tsavas/mega/pantilt_orthos/pantilt_arduino mount.png

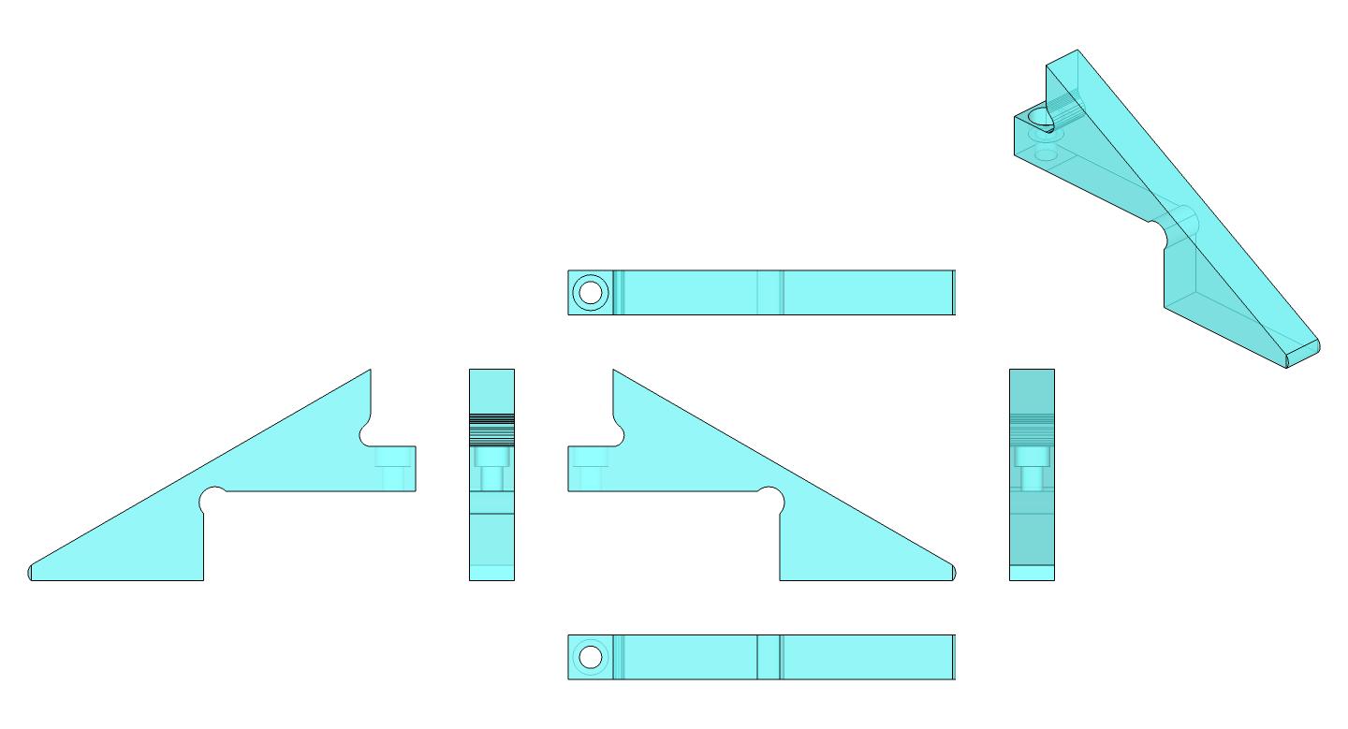
pantilt_orthos/pantilt_arduino mount.png
