tsavas/mega/pantilt_orthos/pantilt_carriage.png

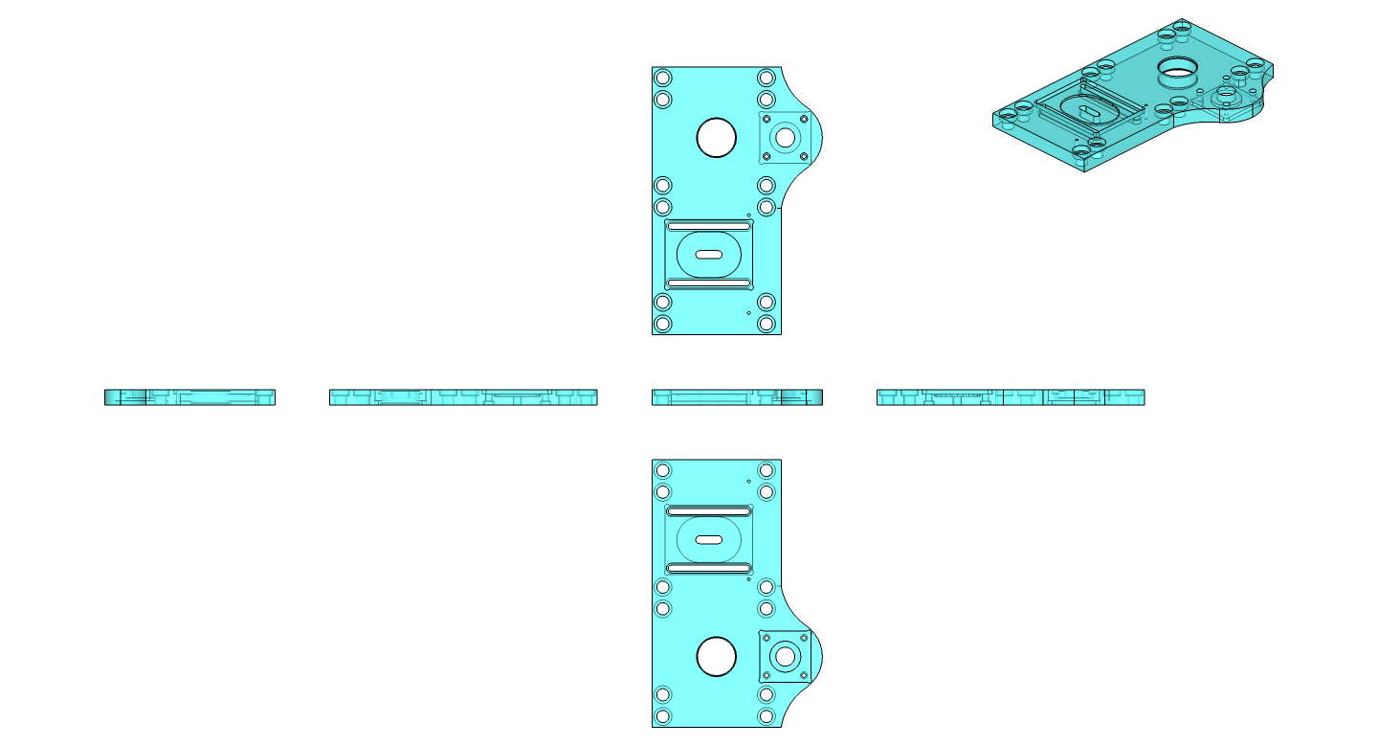
pantilt_orthos/pantilt_carriage.png
