tsavas/mega/pantilt_orthos/pantilt_side bracket_L.png

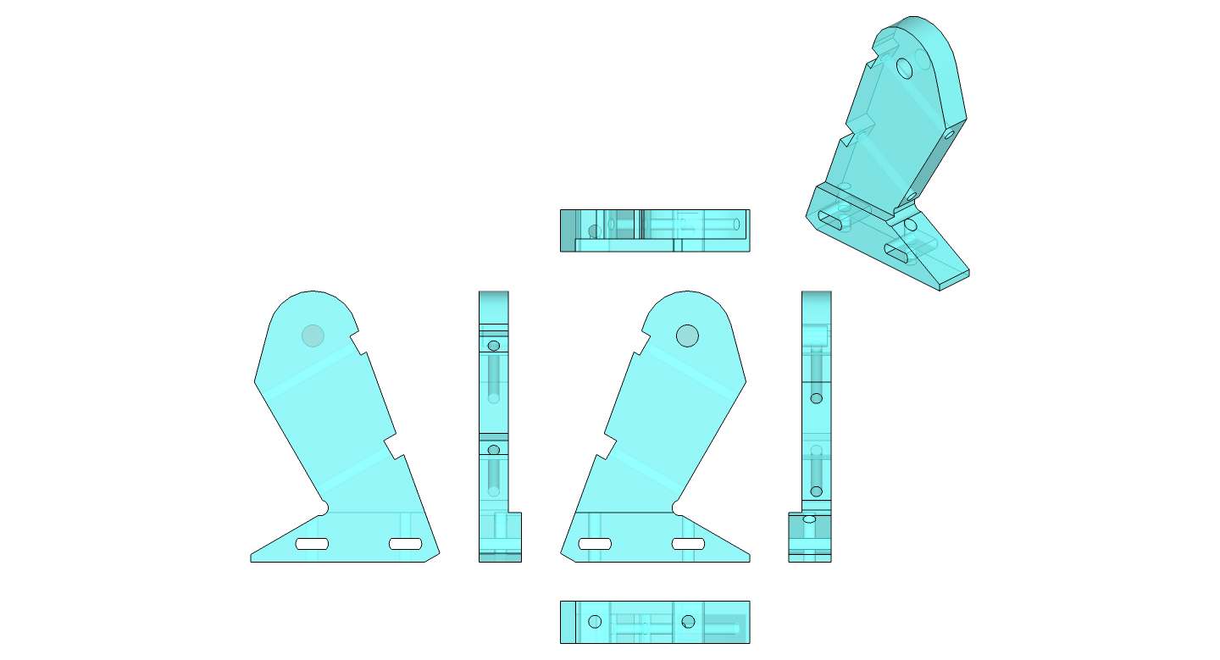
pantilt_orthos/pantilt_side bracket_L.png
