tsavas/mega/pantilt_orthos/pantilt_tilt bracket.png

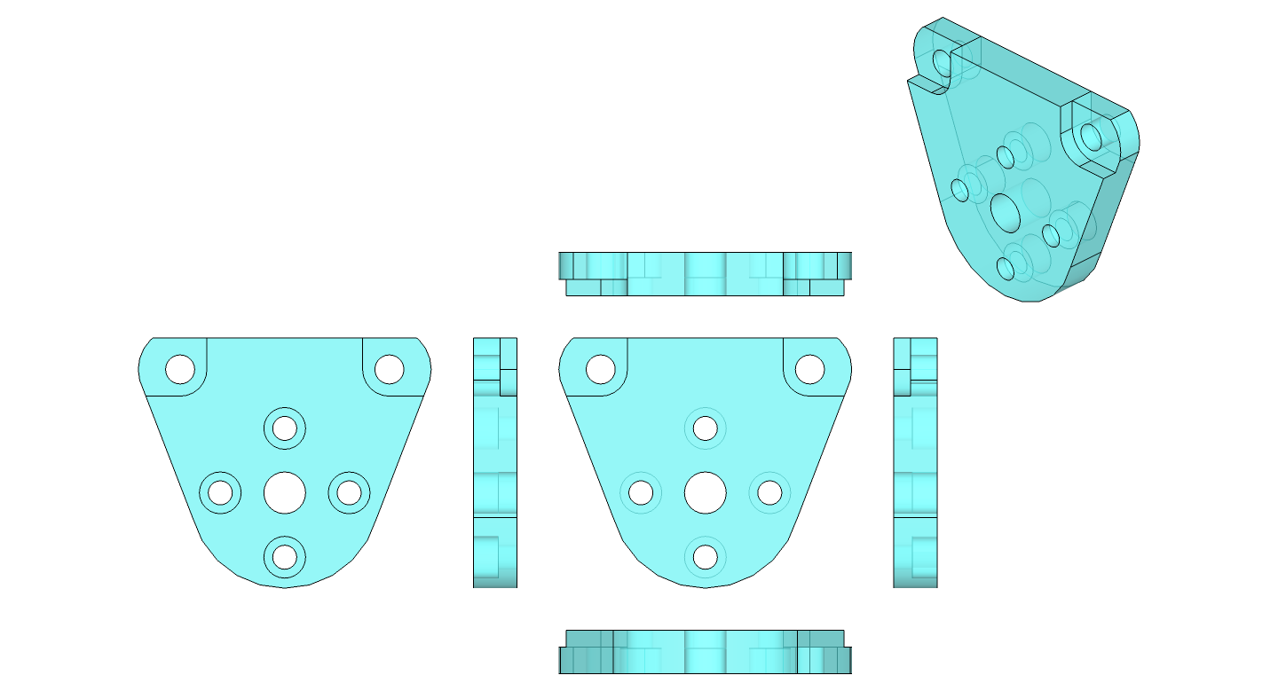
pantilt_orthos/pantilt_tilt bracket.png
