tsavas/mega/pantilt_orthos/pantilt_top plate.png

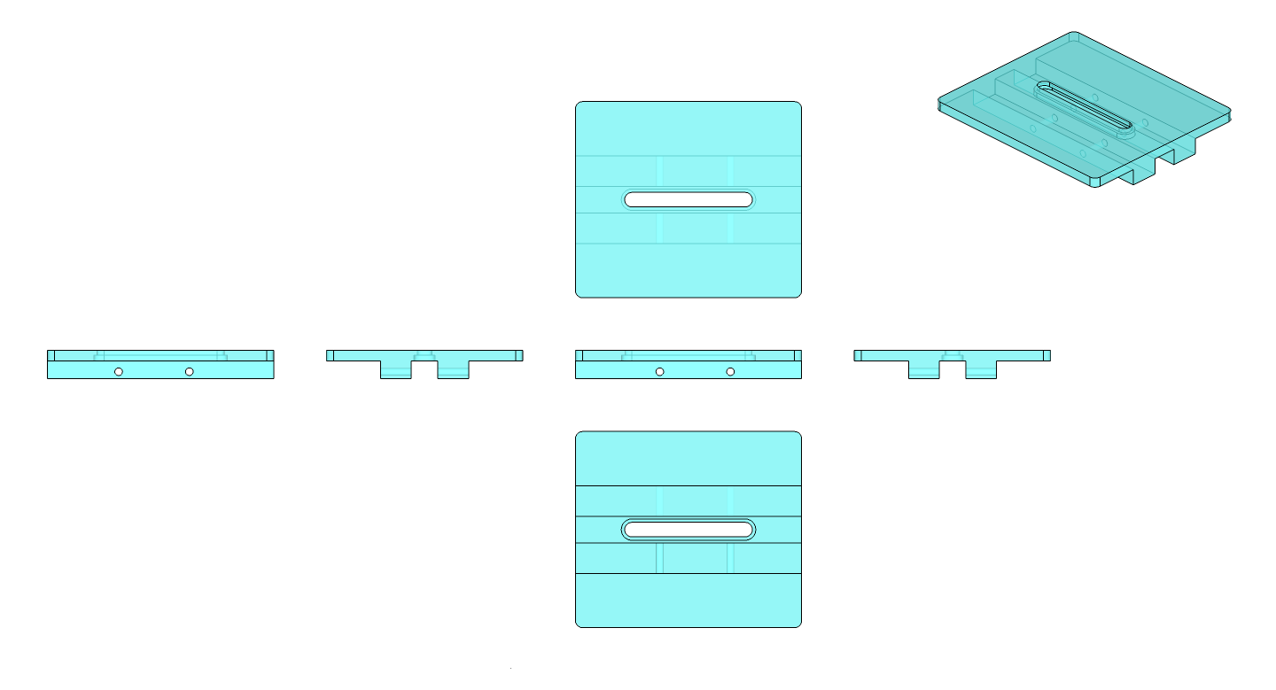
pantilt_orthos/pantilt_top plate.png
