tsavas/mega/pantilt_parts.xlsx

part | price | manufacturer | source | 2D drawing | 3D drawing | description
32 pitch, 20˚ gear rack | $33.73 | McMaster Carr | McMaster Carr (http://www.mcmaster.com/) | x | x
100T, 32 pitch 1" bore gear | $12.99 | Actarobotics | Sparkfun (https://www.sparkfun.com/products/12378) | x | x
16T, 32 pitch 6mm bore gear | $12.99 | Actarobotics | Sparkfun (https://www.sparkfun.com/products/12248) | don't need | x
16T, 32 pitch 6mm bore gear | $12.99 | Actarobotics | Sparkfun (https://www.sparkfun.com/products/12248) | don't need | x
32 pitch, 14.5˚PA worm drive | $20.66 | Boston Gear Works | Amazon (http://www.amazon.com/Boston-Gear-LTHB1-Degree-Pressure/dp/B004N6355Y?redirect=true) | x
14.5˚ PA, 50T worm gear | $38.50 | Boston Gear Works | Amazon (http://www.amazon.com/Boston-Gear-G1029-Plain-Pressure/dp/B004N84ZVK?redirect=true) | x
Igus DryLin W1040-A rail | $88.93 | Igus | Amazon (http://www.amazon.com/DryLin-W1040--Linear-Camera-Slider/dp/B0044DUCVG) | x | x
1/2" x 12" x 12" polycarbonate | $33.00 | McMaster Carr | McMaster Carr (http://www.mcmaster.com/) | o | o
1/4"x 3" pin | $4.20 | McMaster Carr | McMaster Carr (http://www.mcmaster.com/)
Nema 17 stepper motor | $13.99 | Nema | Amazon (http://www.amazon.com/Stepper-Motor-Bipolar-64oz-Printer/dp/B00PNEQI7W?redirect=true) | x
Nema 17 stepper motor | $13.99 | Nema | Amazon (http://www.amazon.com/Stepper-Motor-Bipolar-64oz-Printer/dp/B00PNEQI7W?redirect=true) | x
Nema 23 stepper motor | $16.00 | Nema | Stepper Online (http://www.omc-stepperonline.com/nema-23-stepper-motor-54v-15a-116nm1643ozin-23hs221504s-p-68.html) | x
1/4" pin clamp | $7.99 | Actarobotics | Sparkfun (https://www.sparkfun.com/products/12238) | x | x
1" clamping hub | $5.99 | Actarobotics | Sparkfun (https://www.sparkfun.com/products/12114) | x | x
1" bore shaft | $4.49 | Actarobotics | Actarobotics (https://www.servocity.com/html/1__bore_flanged_aluminum_tubin.html) | x | x
1" bore bearings | $6.48 | Actarobotics | Actarobotics (https://www.servocity.com/html/flanged_ball_bearings.html) | don't have | x
hardware
side bracket bottom hardware
stepper 1 hardware
stepper 2 hardware
stepper 3 hardware
pin bracket hardware
arduino mega
