tsavas/mega/parts 2D drawings/pin clamp.jpg

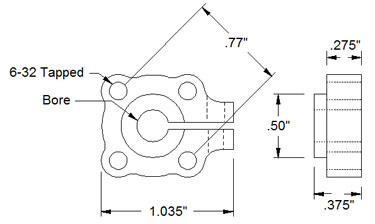
parts 2D drawings/pin clamp.jpg
