tsavas/mega/parts 2D drawings/worm drive.jpg

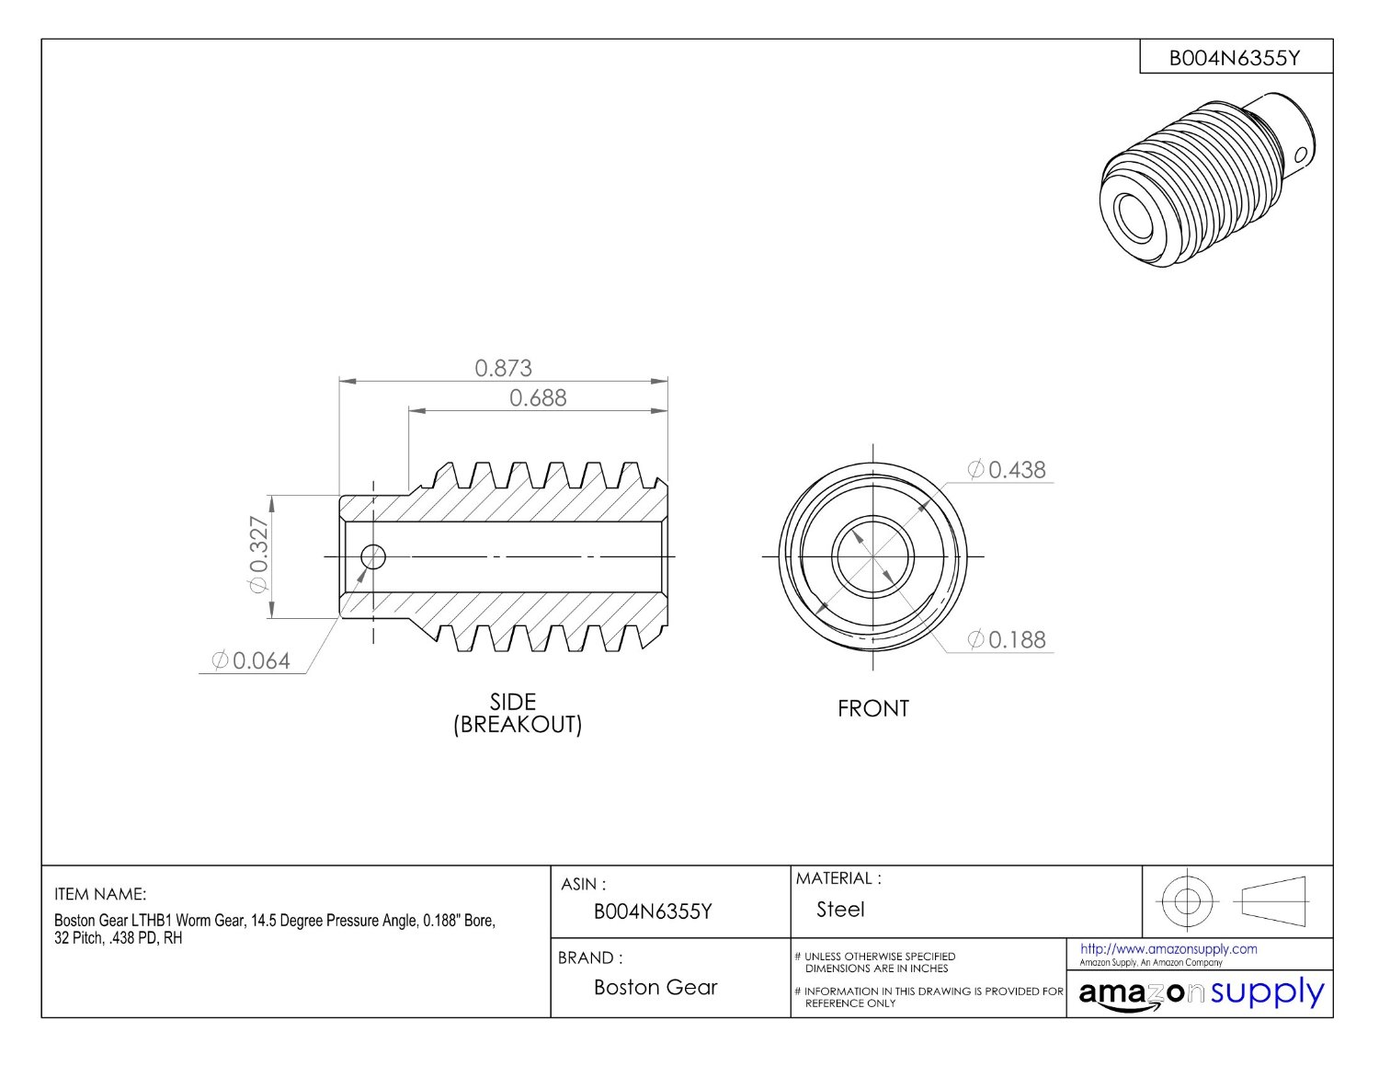
parts 2D drawings/worm drive.jpg
