tsavas/mega/parts 2D drawings/worm gear.jpg

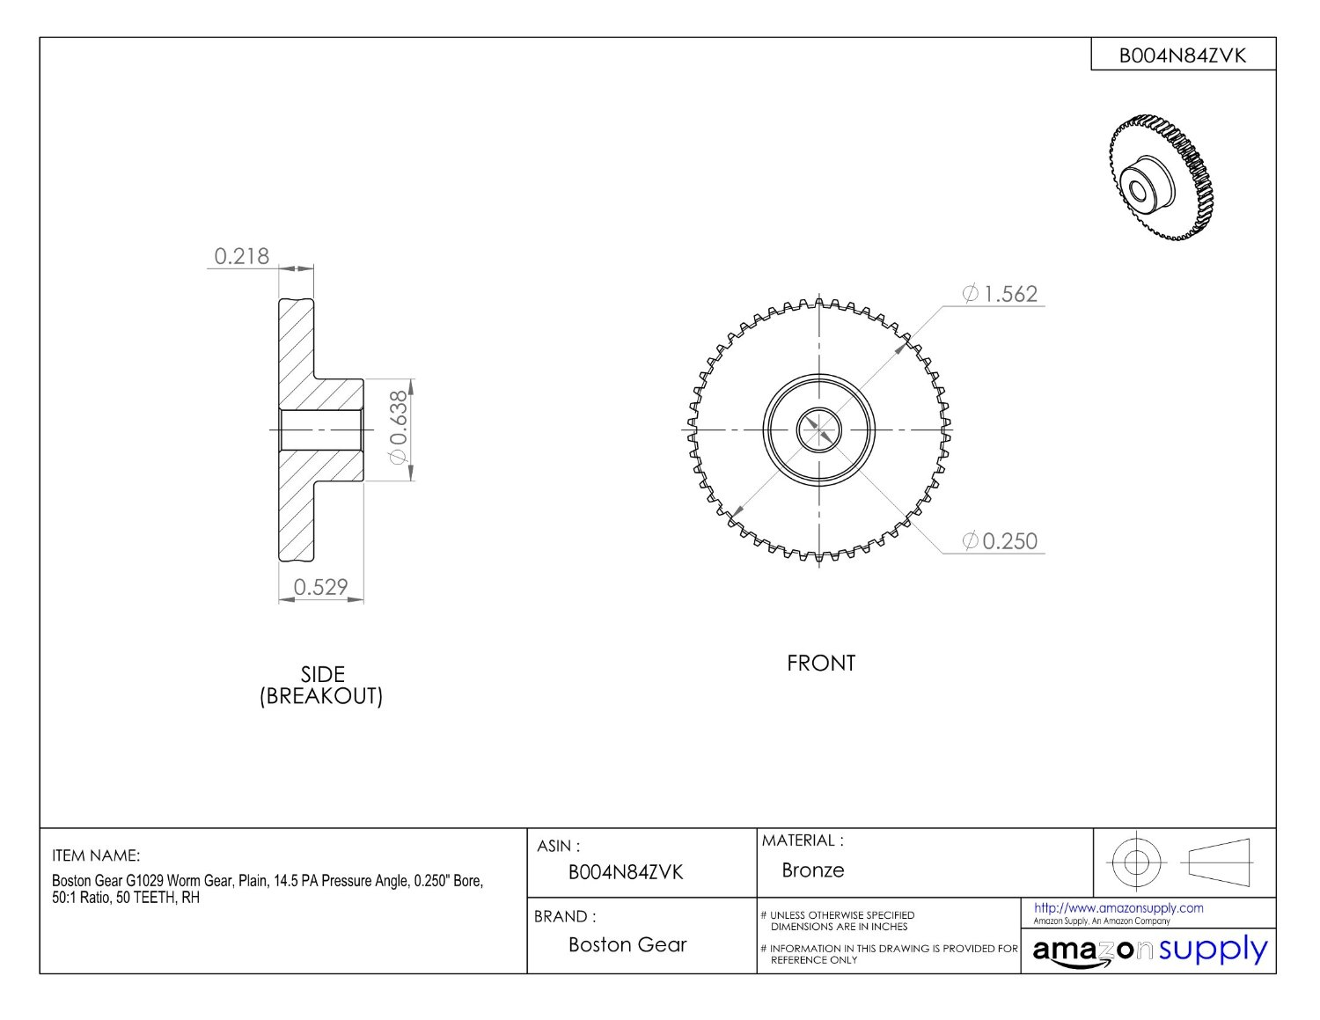
parts 2D drawings/worm gear.jpg
