tsavas/mega/pantilt_stl/pantilt_arduino mount.stl

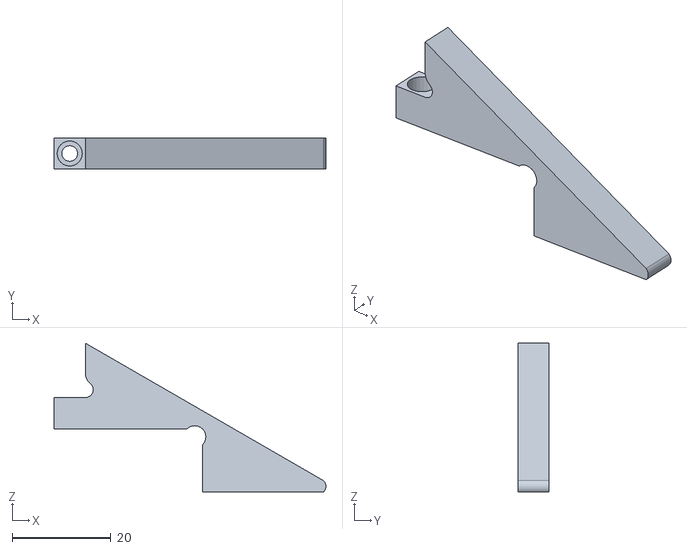
[picture p9: CAD file, 2016-05-07]
pantilt_stl/pantilt_arduino mount.stl
55.0 x 6.35 x 30.0
