tsavas/mega/parts 3D drawings/bearing.STEP

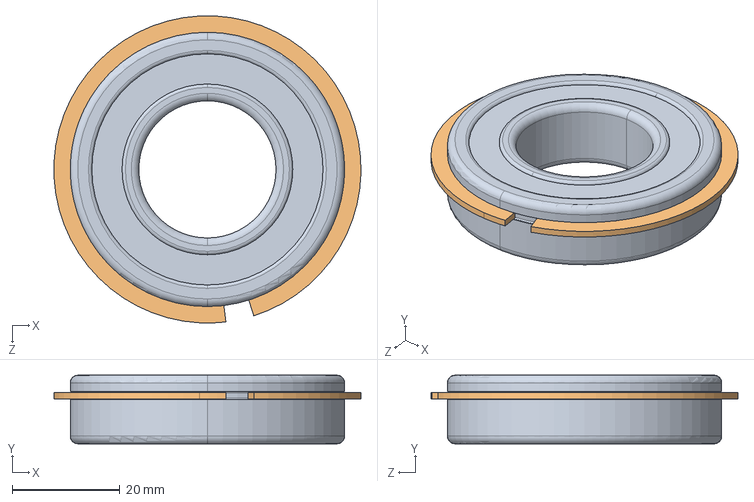
[picture p10: CAD file, 2016-05-07]
parts 3D drawings/bearing.STEP
56.8 x 12.7 x 56.9 mm
535050 snap ring
