tsavas/mega/pantilt_stl/pantilt_side bracket_R.stl

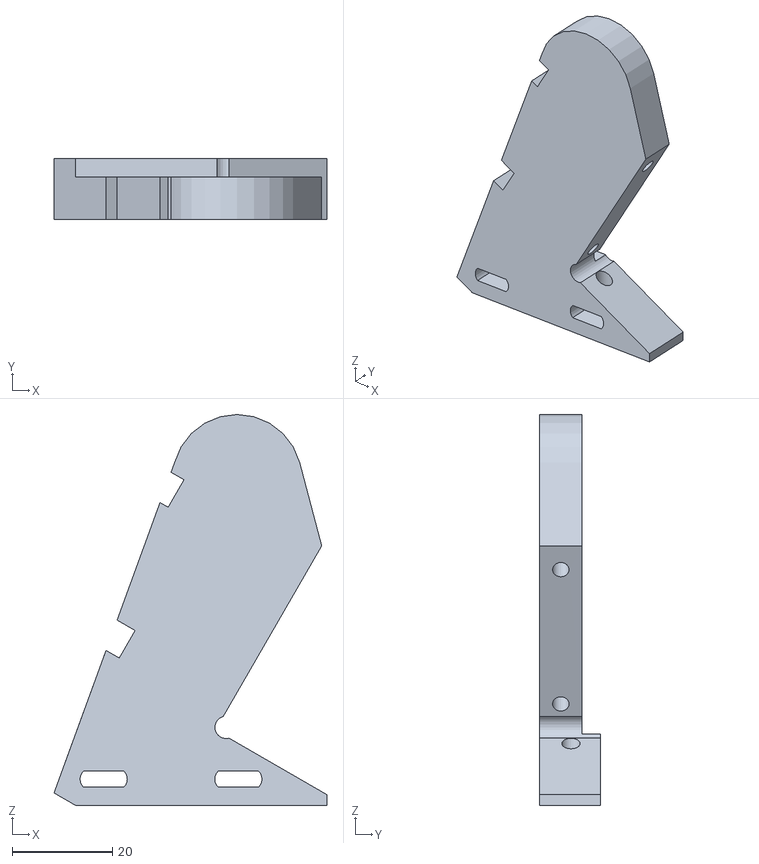
[picture p11: CAD file, 2016-05-07]
pantilt_stl/pantilt_side bracket_R.stl
54.6 x 12.2 x 78.2
