tsavas/mega/pantilt_stl/pantilt_carriage.stl

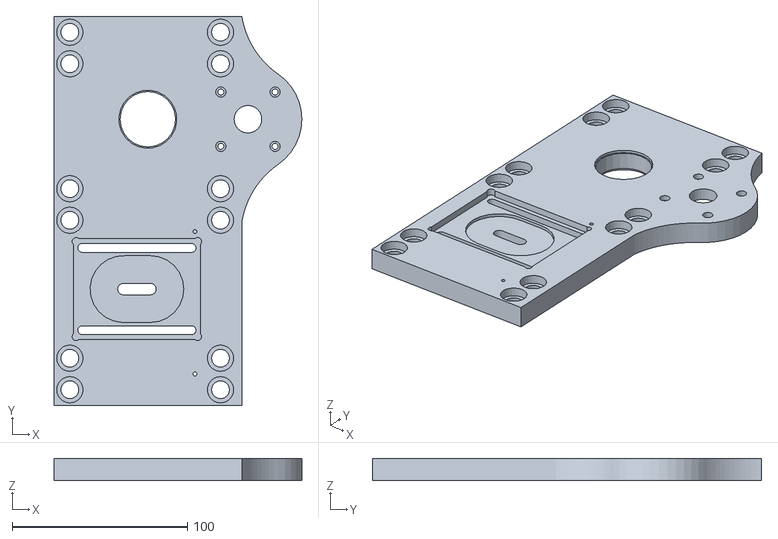
[picture p12: CAD file, 2016-05-07]
pantilt_stl/pantilt_carriage.stl
141.5 x 222.1 x 12.7
