tsavas/mega/parts 3D drawings/clamp hub.step

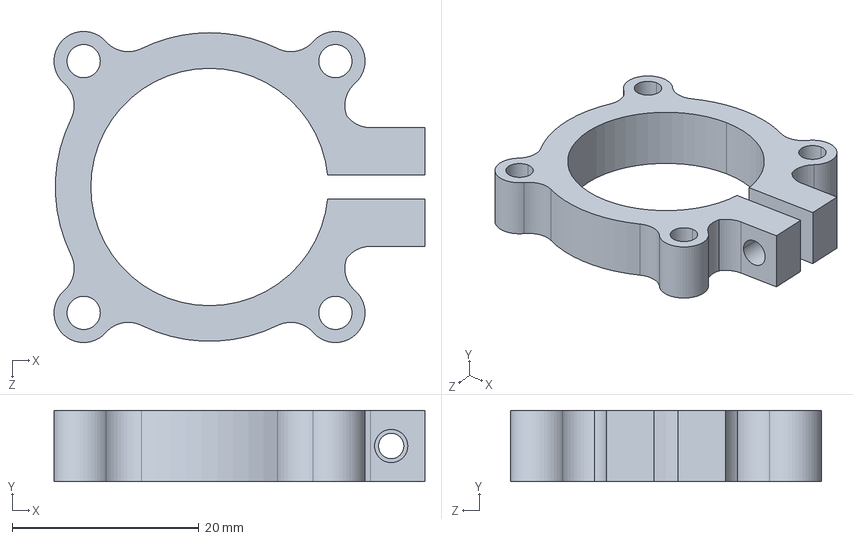
[picture p13: CAD file, 2016-05-07]
parts 3D drawings/clamp hub.step
39.7 x 7.62 x 33.3 mm
