tsavas/mega/pantilt_stl/pantilt_top plate.stl

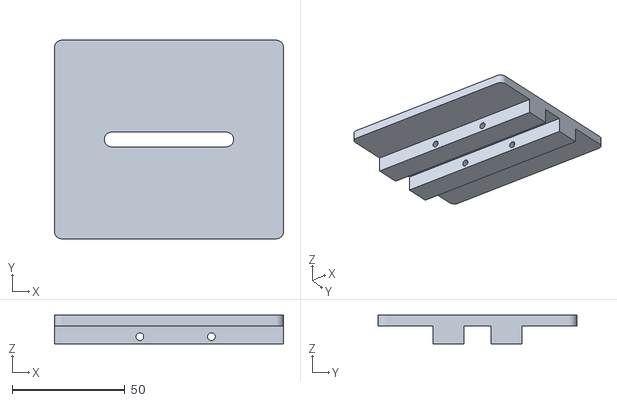
[picture p14: CAD file, 2016-05-07]
pantilt_stl/pantilt_top plate.stl
101.6 x 88.1 x 12.7
