tsavas/mega/parts 3D drawings/small gear.step

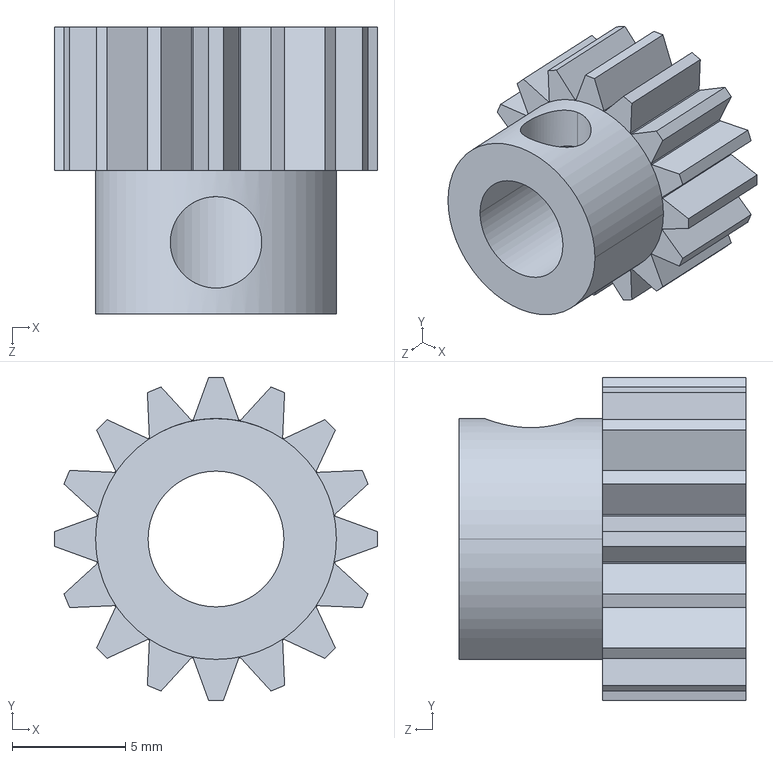
[picture p15: CAD file, 2016-05-07]
parts 3D drawings/small gear.step
14.3 x 14.3 x 12.7 mm
