tsavas/mega/pantilt_stl/pantilt_tilt bracket.stl

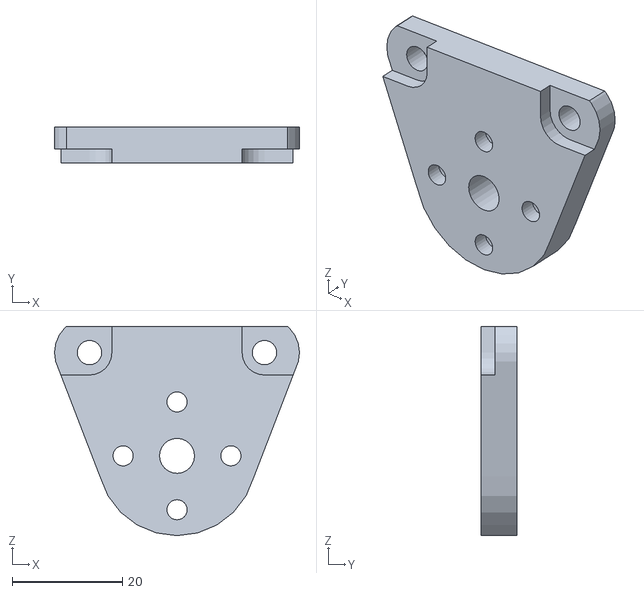
[picture p16: CAD file, 2016-05-07]
pantilt_stl/pantilt_tilt bracket.stl
44.5 x 6.60 x 38.0
