tsavas/mega/parts 3D drawings/WS_10_40_200_1.stp

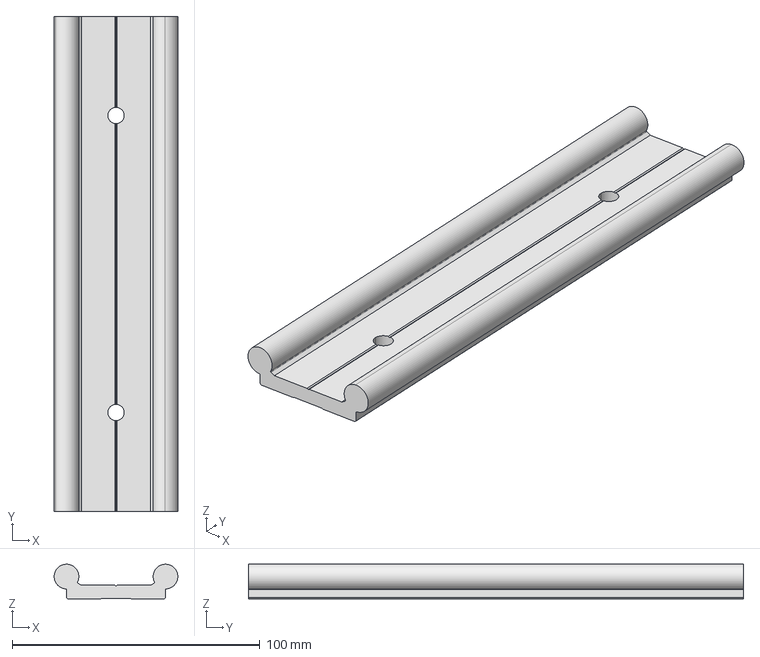
[picture p17: CAD file, 2016-05-07]
parts 3D drawings/WS_10_40_200_1.stp
50.0 x 200.0 x 14.0 mm
