tsavas/mega/parts 3D drawings/hollow shaft.STEP

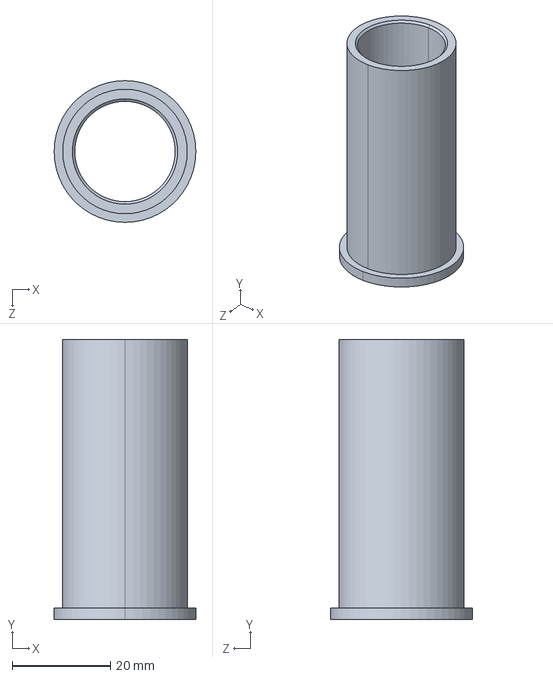
[picture p18: CAD file, 2016-05-07]
parts 3D drawings/hollow shaft.STEP
28.9 x 57.1 x 28.9 mm
