tsavas/mega/parts 3D drawings/100T Gear.stp

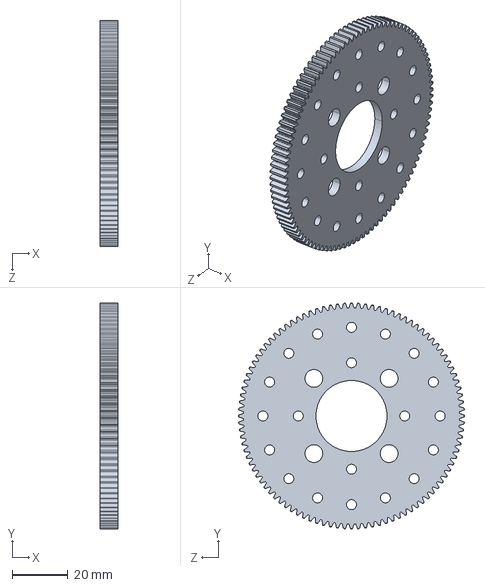
[picture p19: CAD file, 2016-05-07]
parts 3D drawings/100T Gear.stp
6.35 x 81.0 x 81.0 mm
