tsavas/mega/parts 3D drawings/7854K130.STEP

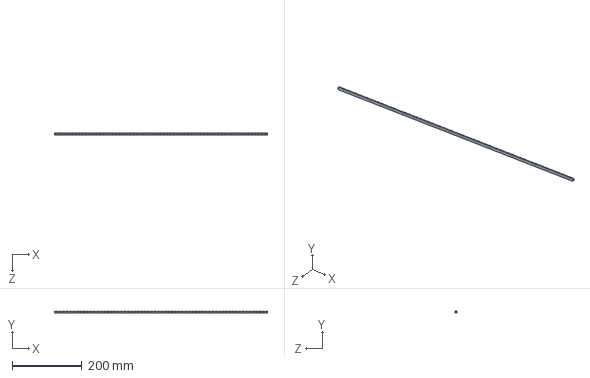
[picture p21: CAD file, 2016-05-07]
parts 3D drawings/7854K130.STEP
609.6 x 4.78 x 4.76 mm
