tsavas/mega/(list of files, cad)

Other CAD files:
pantilt_stl/pantilt_side bracket_L.stl
pantilt_dxf/pantilt_arduino mount.dxf
pantilt_dxf/pantilt_carriage.dxf
pantilt_dxf/pantilt_side bracket_L.dxf
pantilt_dxf/pantilt_side bracket_R.dxf
pantilt_dxf/pantilt_tilt bracket.dxf
pantilt_dxf/pantilt_top plate.dxf
