tsavas/mega/parts 2D drawings/DryLin WQ10.pdf

# DryLin® W Linear Guide Systems Double Rail and Bearing Block - Square

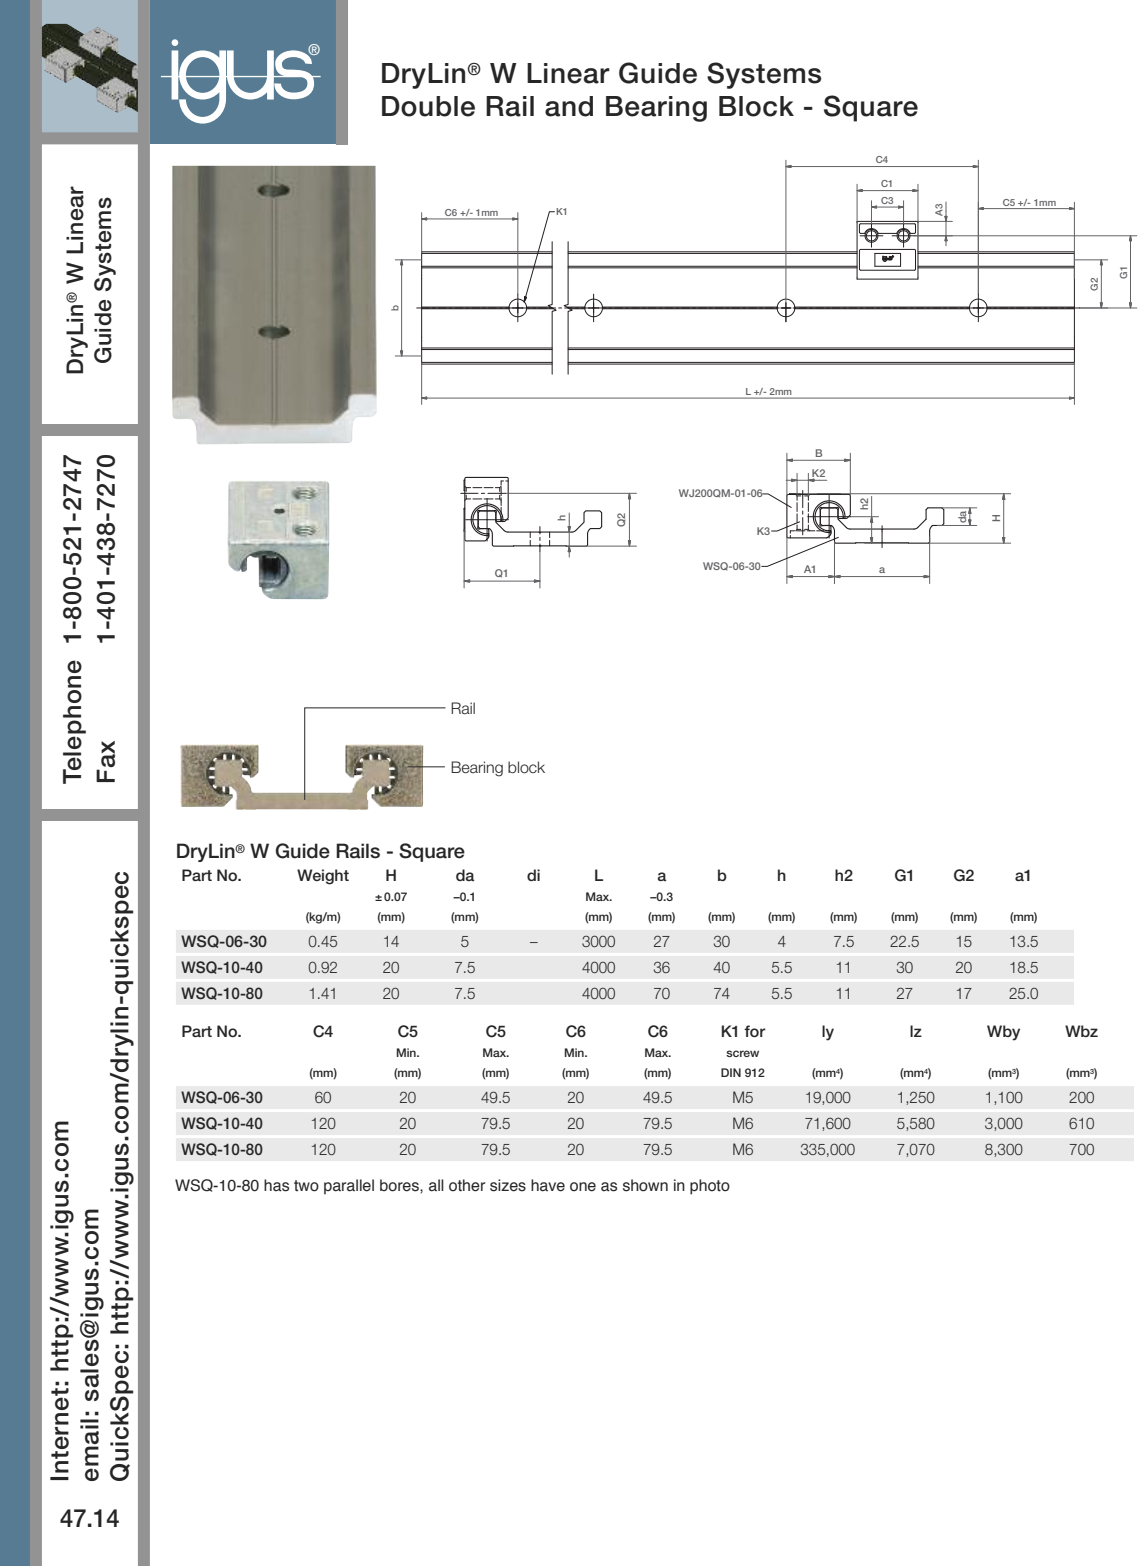
[picture p22: page 1]
Dry; Lin; uid; ste; Intern; et: http://; ail: s; ale; uic; c: http://; drylin-q; Tele; WSQ-06-30; Rail; Bearing block; Part No.; K1 for; Wby; Wbz; Min.; Max.; screw; DIN 912; (mm⁴); (mm³); WSQ-10-40; WSQ-10-80; Weight

DryLin® W Guide Rails - Square

WSQ-10-80 has two parallel bores, all other sizes have one as shown in photo

# Guide Carriage, Fitted - Square

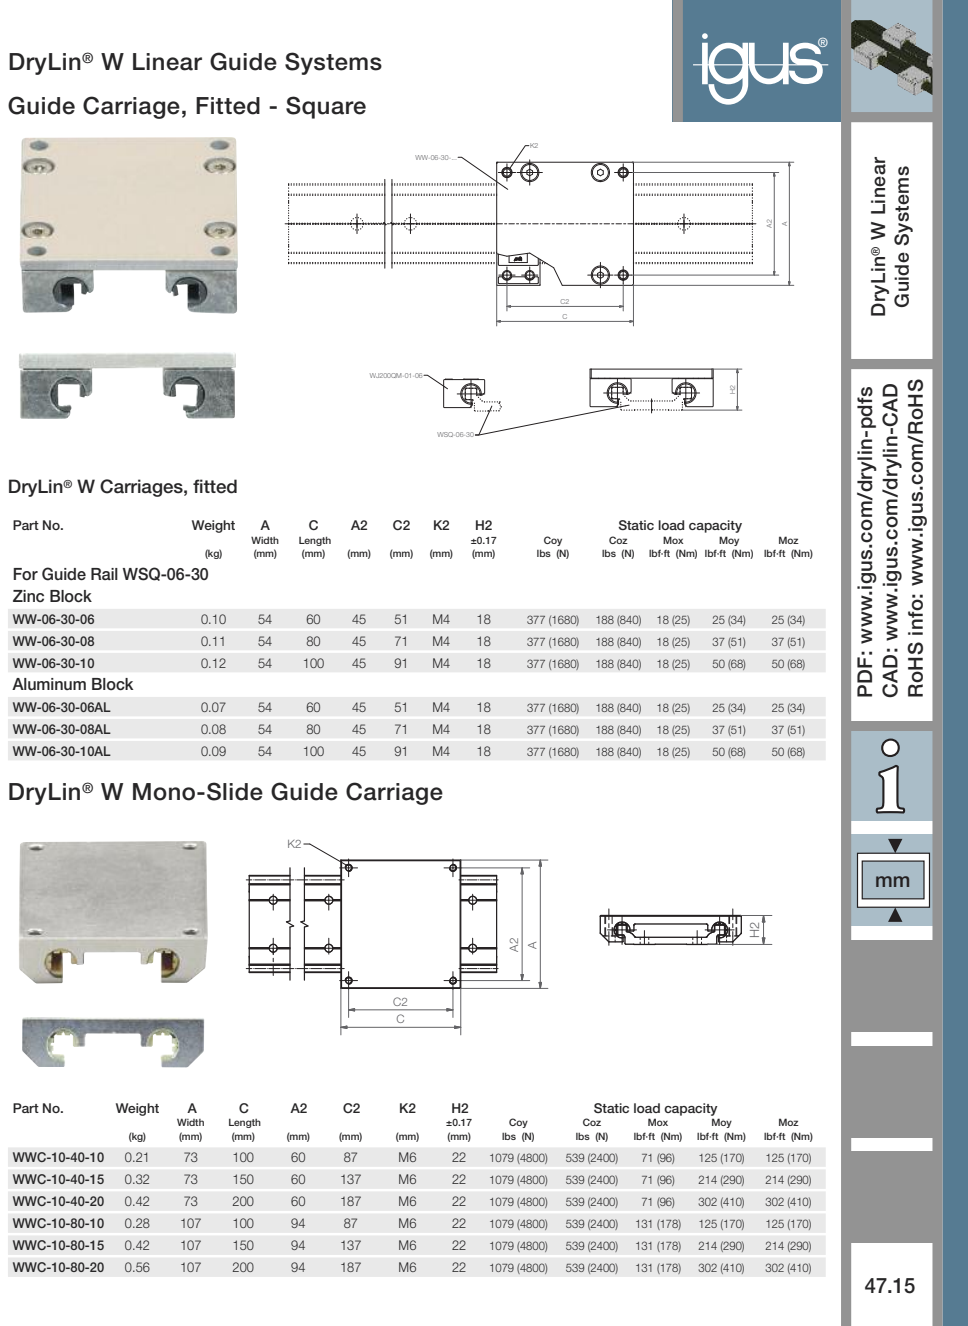
[picture p23: page 2]
drylin-p; dfs; drylin-C; S info: w; Dry; Lin; uid; ste; WSQ-06-30; Part No.; Weight; Static load capacity; Width; Length; Coy; Coz; Mox; Moy; Moz; lbs (N); lbf·ft (Nm) lbf·ft (Nm) lbf·ft (Nm); Aluminum Block; lbf·ft (Nm); WWC-10-40-10; WWC-10-40-15; WWC-10-40-20; WWC-10-80-10; WWC-10-80-15; WWC-10-80-20

DryLin® W Carriages, fitted

For Guide Rail WSQ-06-30
Zinc Block

DryLin® W Mono-Slide Guide Carriage

# Double Rail and Bearing Block - Round

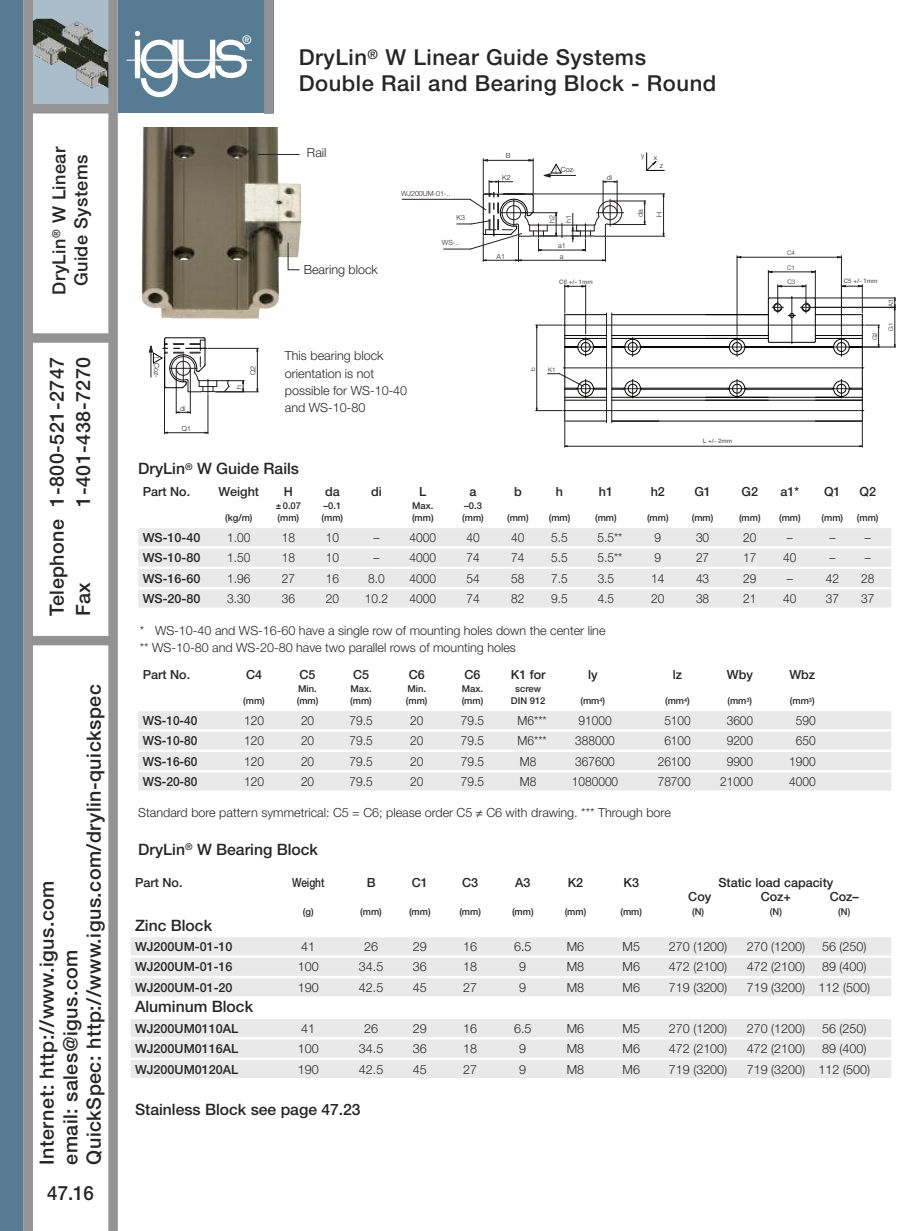
[picture p24: page 3]
Dry; Lin; uid; ste; Intern; et: http://; ail: s; ale; uic; c: http://; drylin-q; Tele; ! Coz-; Part No.; Weight; Max.; K1 for; Wby; Wbz; Min.; screw; DIN 912; (mm⁴); (mm³); Static load capacity; Coy; Coz+; Coz–; Zinc Block; Aluminum Block; Rail; Bearing block

This bearing block
orientation is not
possible for WS-10-40
and WS-10-80

DryLin® W Guide Rails

* WS-10-40 and WS-16-60 have a single row of mounting holes down the center line
** WS-10-80 and WS-20-80 have two parallel rows of mounting holes

Standard bore pattern symmetrical: C5 = C6; please order C5 ≠ C6 with drawing. *** Through bore

DryLin® W Bearing Block

Stainless Block see page 47.23
