tsavas/mega/parts 2D drawings/gear rack.pdf

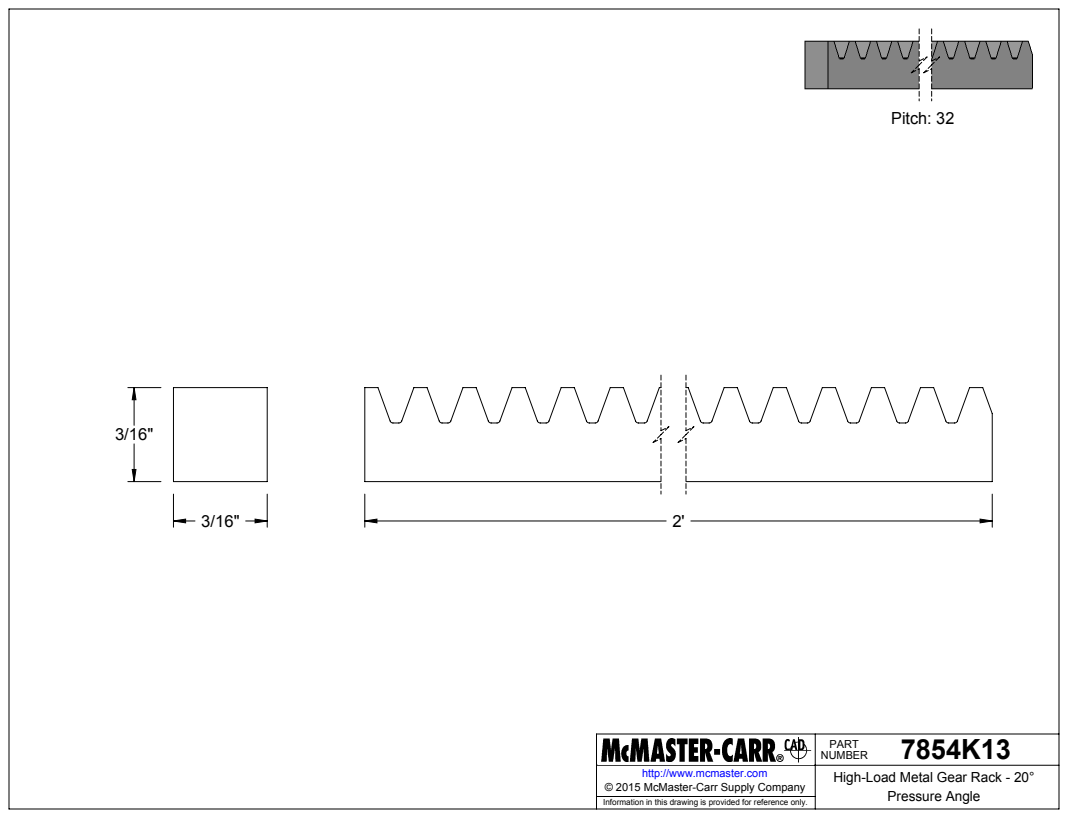
[picture p25: page 1]
Pitch: 32

7854K13 PART NUMBER

http://www.mcmaster.com | High-Load Metal Gear Rack - 20° Pressure Angle © 2015 McMaster-Carr Supply Company

Information in this drawing is provided for reference only.
