tsavas/mega/parts 2D drawings/nema 23.pdf

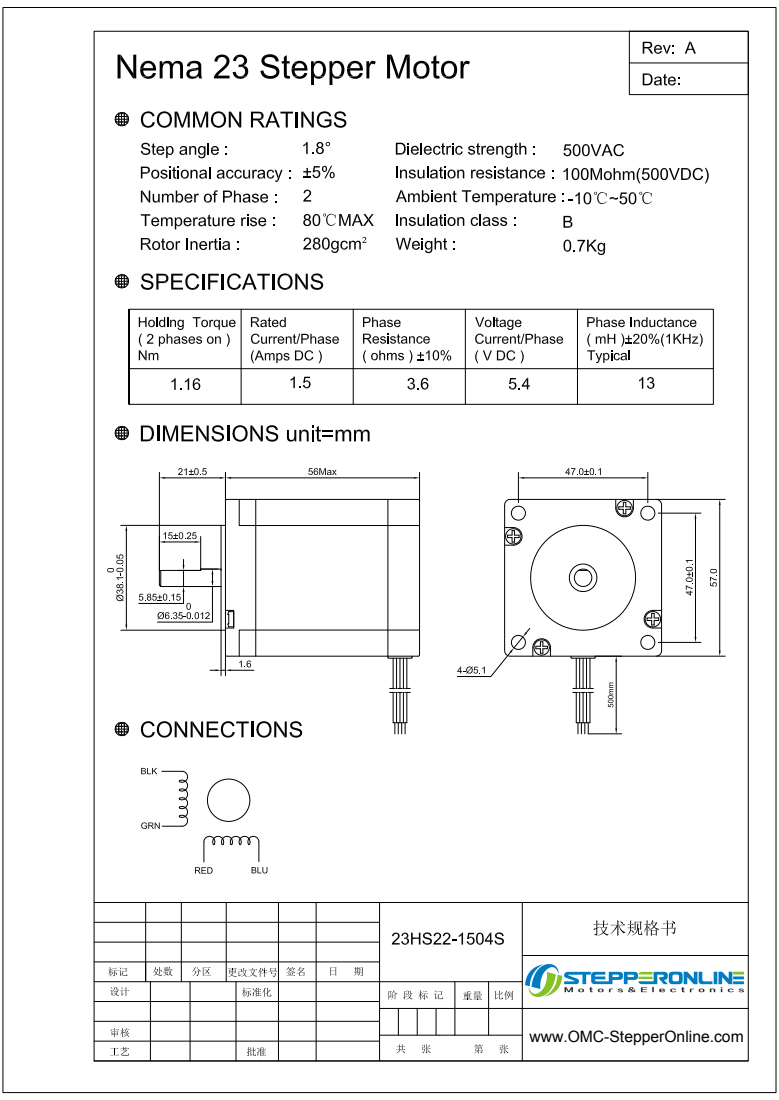
[picture p26: page 1]

www.OMC-StepperOnline.com
