tsavas/mega/pantilt_pdf/pantilt_arduino mount.pdf

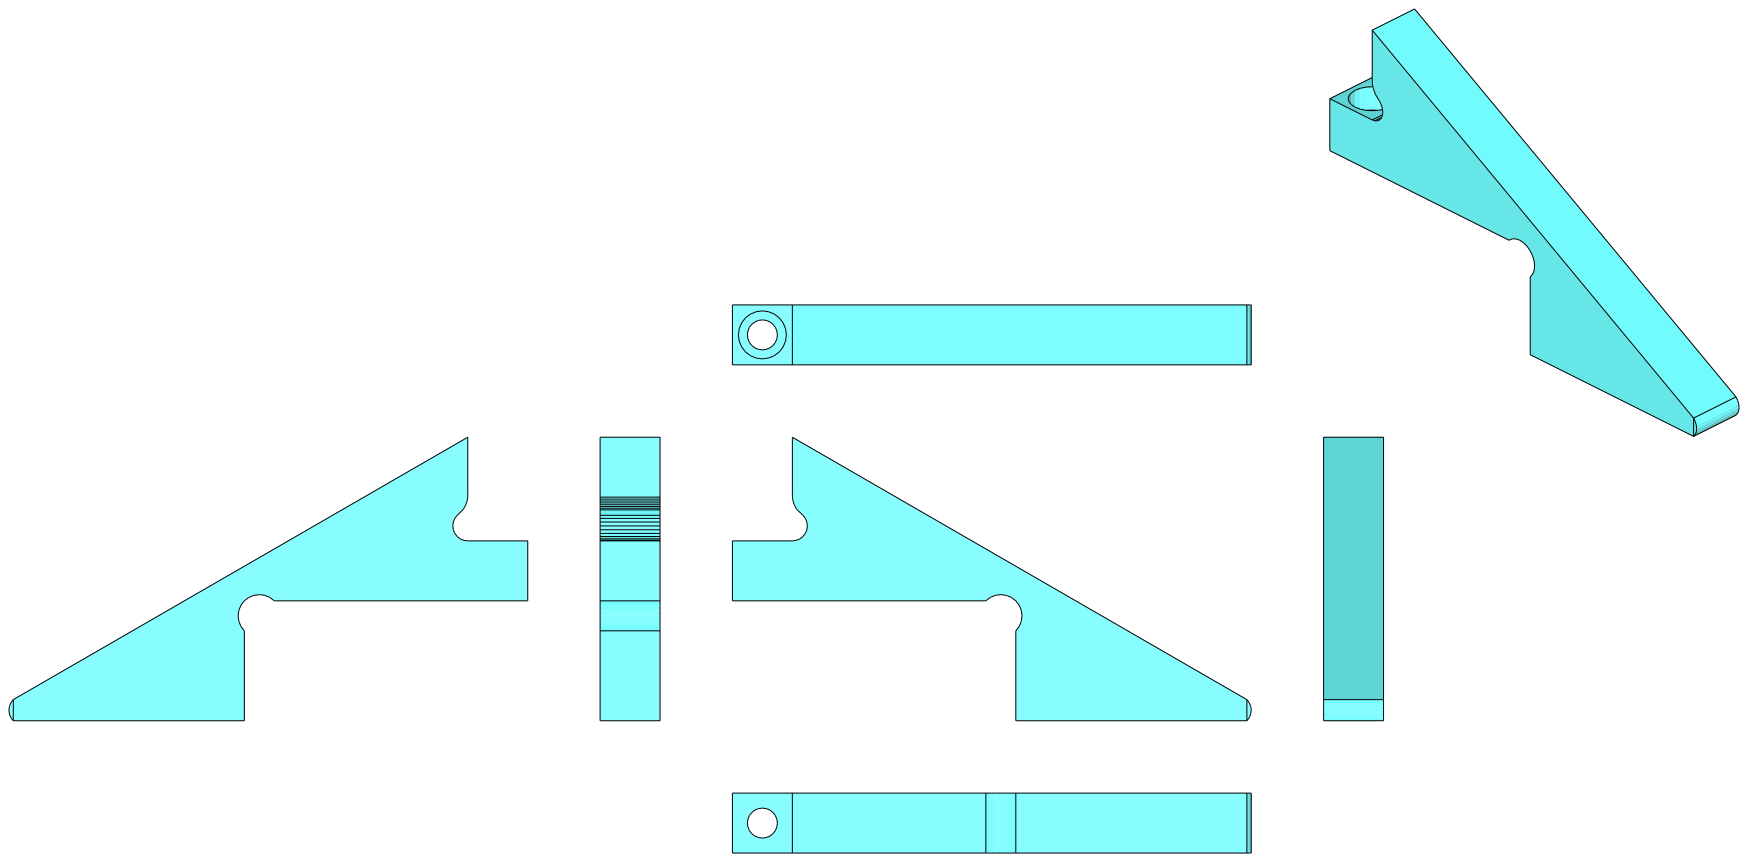
[picture p28: page 1]
