tsavas/mega/pantilt_pdf/pantilt_carriage.pdf

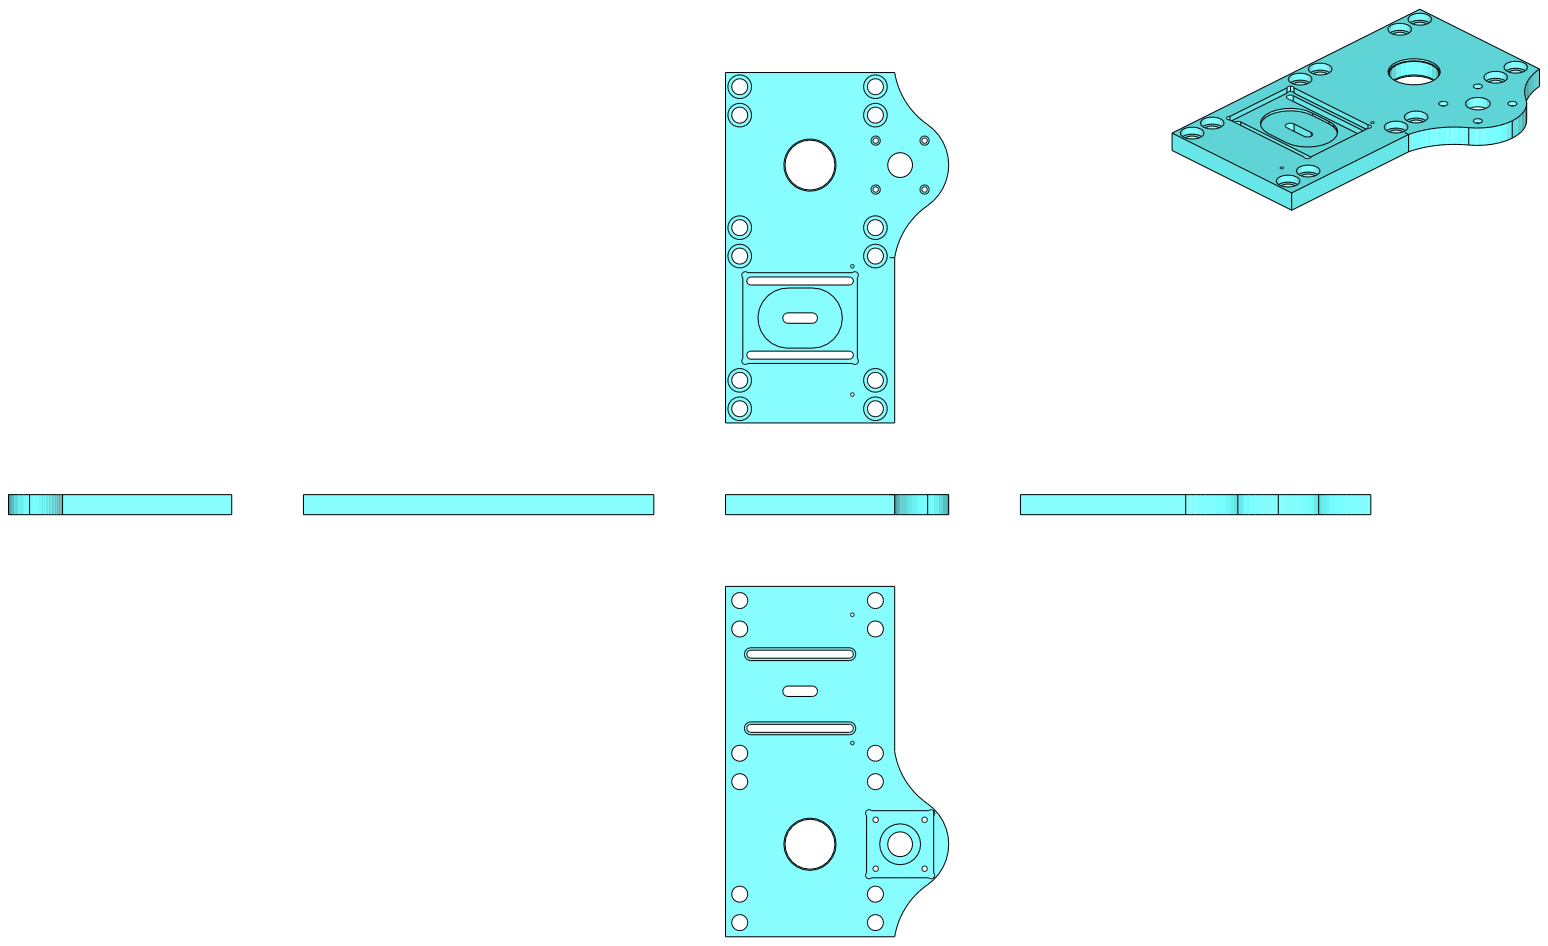
[picture p29: page 1]
