tsavas/mega/pantilt_pdf/pantilt_side bracket_L.pdf

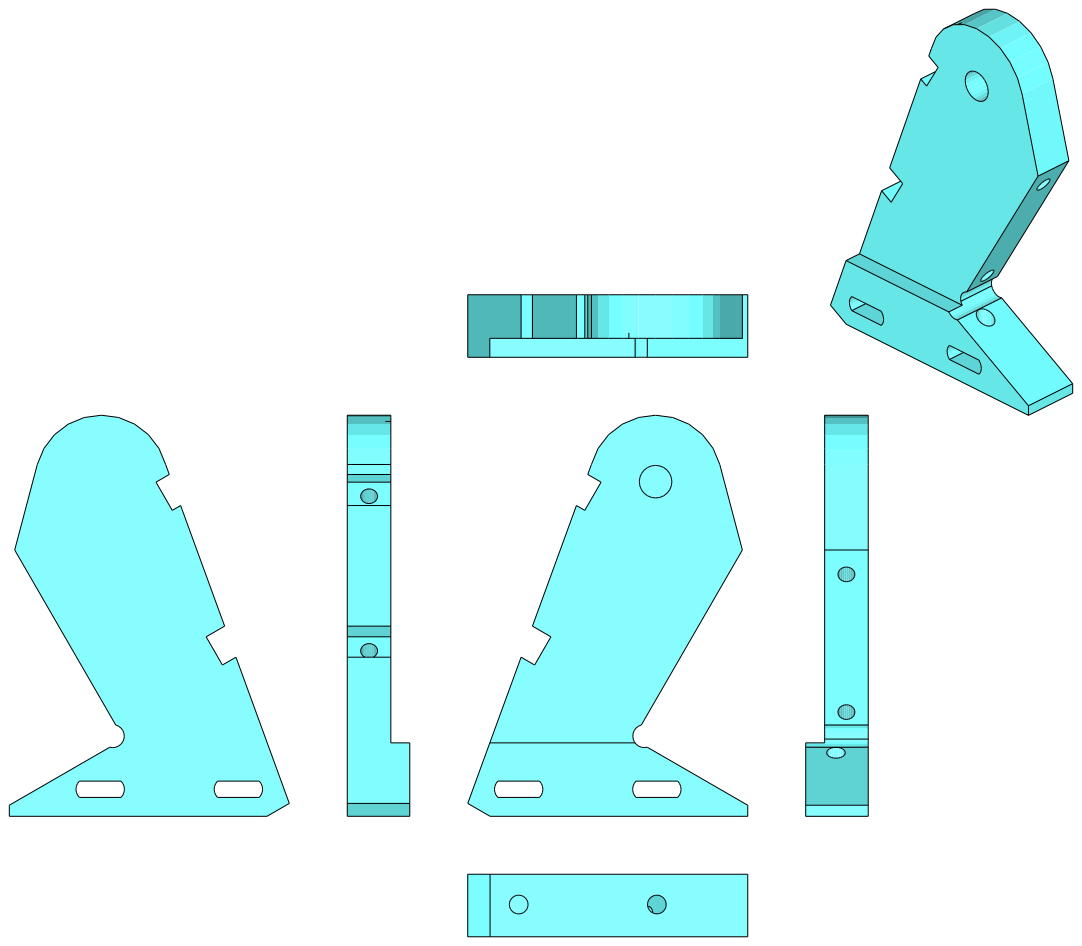
[picture p30: page 1]
