tsavas/mega/pantilt_pdf/pantilt_side bracket_R.pdf

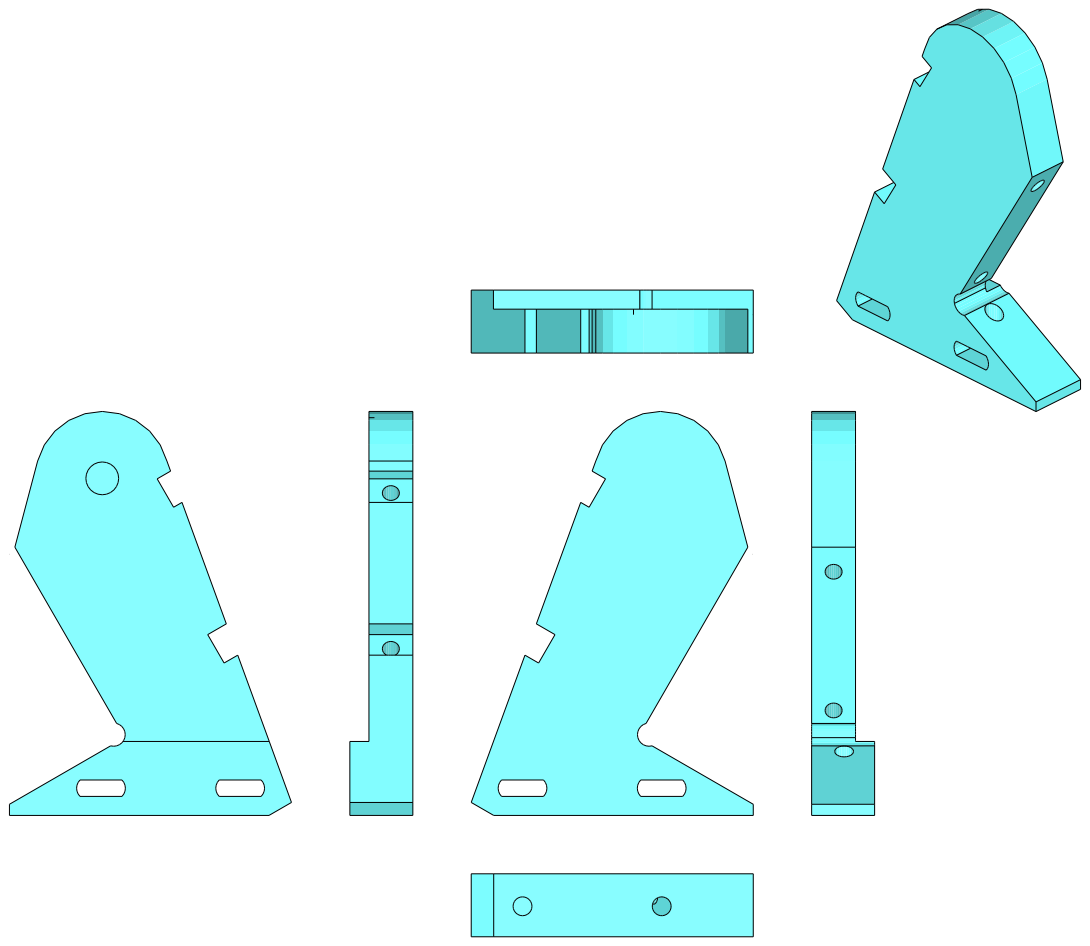
[picture p31: page 1]
