tsavas/mega/pantilt_pdf/pantilt_tilt bracket.pdf

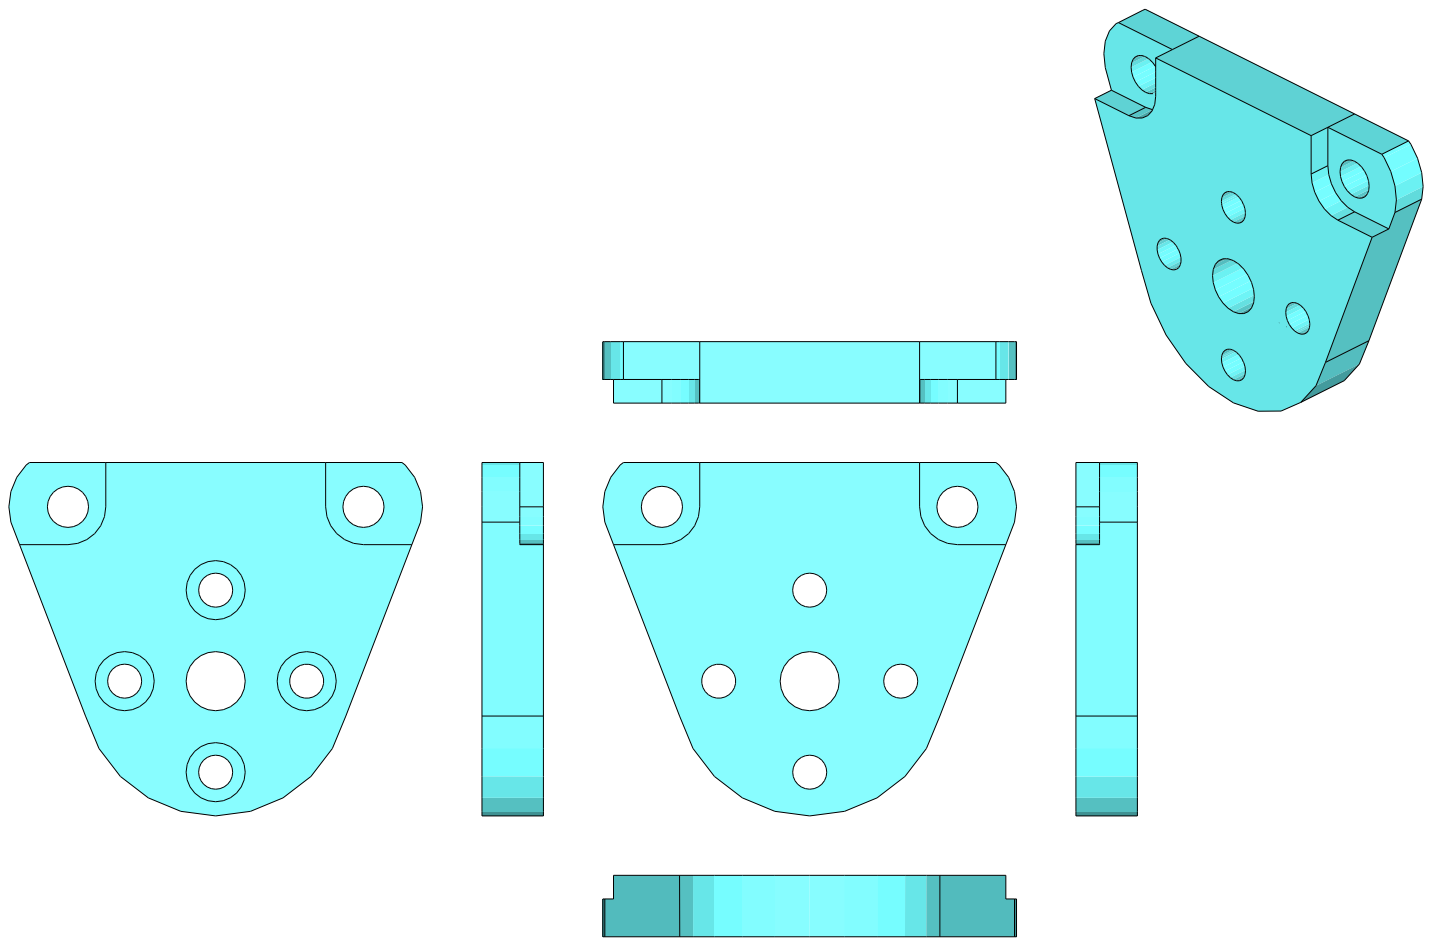
[picture p32: page 1]
