tsavas/mega/pantilt_pdf/pantilt_top plate.pdf

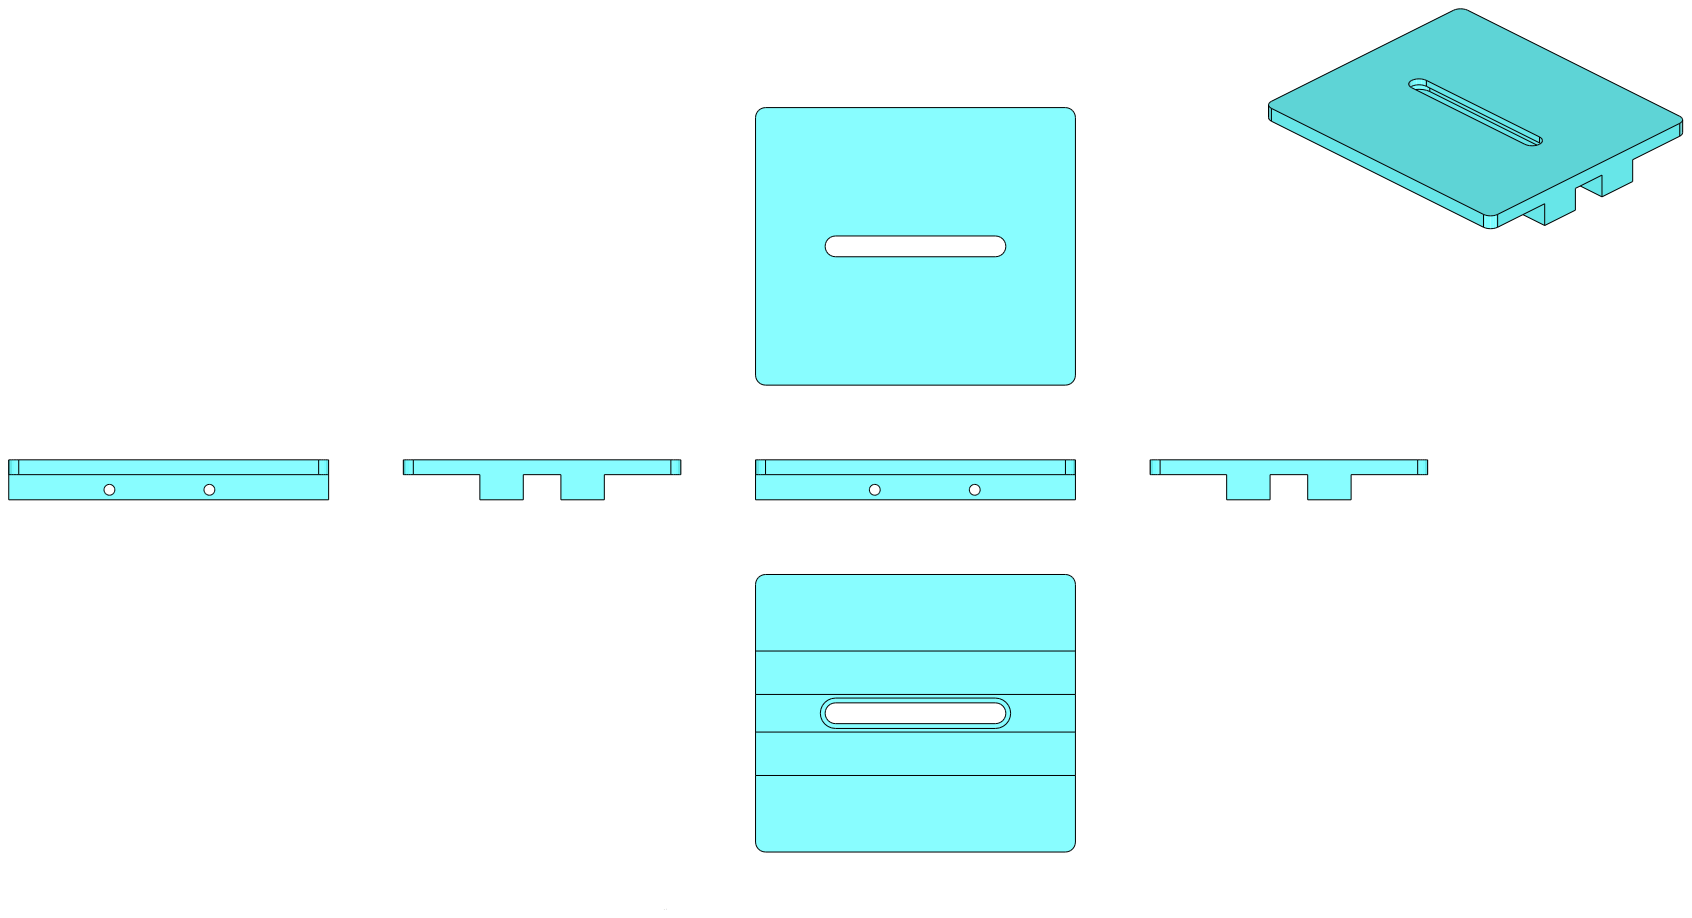
[picture p33: page 1]
