tsavas/mega/(commit log)

2016-05-07 Adding boiler plate files
    Adding a gitignore and gitattributes file
2016-05-07 Testing a dxf large file
    Running a test to see if I can upload a 100MB file
    [pantilt_carriage.dxf]
2016-05-07 Adding core components to project
    Starting out this repository with a bank of all project files, including parts list, CAD files in various formats, and original Sketchup drawings.
    [100T Gear.stp, 7854K130.STEP, WS_10_40_200_1.stp, bearing.STEP, clamp hub.step, hollow shaft.STEP, pantilt_arduino mount.dxf, pantilt_arduino mount.stl]
